IoakeimSogiakas/LibreHomeBus/hardware/Flavors/CH32V003FID4/FID4.xls

LCSC# | Mfr. | Mrf# | Description | Quantity | Product
C3191125 | TPS92520QDAPRQ1 | TI | LED Driver IC 2 Output DC-DC Buck PWM Analog Dimming 1600mA HTSSOP-32 | 1 | https://www.lcsc.com/product-detail/C3191125.html
C13832 | CL31B105KCHNNNE | Samsung Electro-Mechanics | 1uF ±10% 100V Ceramic Capacitor X7R 1206 | 5 | https://www.lcsc.com/product-detail/C13832.html
C577211 | CC1206KKX7R0BB225 | YAGEO | 2.2uF ±10% 100V Ceramic Capacitor X7R 1206 | 7 | https://www.lcsc.com/product-detail/C577211.html
C113906 | CC1206KRX7R9BB222 | YAGEO | 2.2nF ±10% 50V Ceramic Capacitor X7R 1206 | 3 | https://www.lcsc.com/product-detail/C113906.html
C1945 | CL31B104KCFNNNE | Samsung Electro-Mechanics | 100nF ±10% 100V Ceramic Capacitor X7R 1206 | 6 | https://www.lcsc.com/product-detail/C1945.html
C71084 | CL31B474KBHNNNE | Samsung Electro-Mechanics | 470nF ±10% 50V Ceramic Capacitor X7R 1206 | 2 | https://www.lcsc.com/product-detail/C71084.html
C14996 | SS210 | MDD(Microdiode Semiconductor) | Diode 100V 2A Surface Mount SMA(DO-214AC) | 2 | https://www.lcsc.com/product-detail/C14996.html
C18222152 | MNR1050T271MT | MetalLions | 900mA 270uH ±20% 1.5A 858mΩ Magnetic Shielded Inductor SMD,10x10mm Fixed Inductors | 2 | https://www.lcsc.com/product-detail/C18222152.html
C97853 | BLM18PG471SN1D | muRata | 470Ω@100MHz 1 Line Ferrite Bead 0603 1A 200mΩ | 2 | https://www.lcsc.com/product-detail/C97853.html
C54921095 | HRC0805F10R0FNTN | HWA CHN | 125mW 10Ω 150V Thick Film Resistor ±150ppm/℃ ±1% 0805 Chip Resistor - Surface Mount | 3 | https://www.lcsc.com/product-detail/C54921095.html
C55098665 | HRC0805J472 FNTN | HWA CHN | 125mW 4.7kΩ 150V Thick Film Resistor ±100ppm/℃ ±5% 0805 Chip Resistor - Surface Mount | 1 | https://www.lcsc.com/product-detail/C55098665.html
C54921094 | HRC0805F1002FNTN | HWA CHN | 10kΩ 125mW 150V Thick Film Resistor ±1% ±100ppm/℃ 0805 Chip Resistor - Surface Mount | 6 | https://www.lcsc.com/product-detail/C54921094.html
C48579717 | 1206X7R475K250NT | AIDE CAPACITOR | 4.7uF ±10% 25V Ceramic Capacitor X7R 1206 | 1 | https://www.lcsc.com/product-detail/C48579717.html
C6119987 | CGA1206X7R106K250NT | HRE | 10uF ±10% 25V Ceramic Capacitor X7R 1206 | 1 | https://www.lcsc.com/product-detail/C6119987.html
C5751958 | LM5168PDDAR | TI | Step-down type 1MHz Adjustable 300mA SO-PowerPAD-8 Voltage Regulators - DC DC Switching Regulators RoHS | 1 | https://www.lcsc.com/product-detail/C5751958.html
C18222021 | MNR4020T680MT | MetalLions | 500mA 68uH ±20% 670mA 1.13Ω Magnetic Shielded Inductor SMD,4x4mm Fixed Inductors | 1 | https://www.lcsc.com/product-detail/C18222021.html
C282859 | TCC1206X7R332K500DT | CCTC | 3.3nF ±10% 50V Ceramic Capacitor X7R 1206 | 1 | https://www.lcsc.com/product-detail/C282859.html
C915858 | TCC1206COG560J500DT | CCTC | 56pF ±5% 50V Ceramic Capacitor C0G 1206 | 1 | https://www.lcsc.com/product-detail/C915858.html
C55585661 | RI0805L2492FT | Guangdong Hottech | 24.9kΩ 125mW 150V Thick Film Resistor ±100ppm/℃ ±1% 0805 Chip Resistor - Surface Mount | 1 | https://www.lcsc.com/product-detail/C55585661.html
C50397082 | CL0805FN137KPS | CHANGLONG | 125mW 137kΩ 150V Thick Film Resistor ±1% 0805 Chip Resistor - Surface Mount RoHS | 1 | https://www.lcsc.com/product-detail/C50397082.html
C55098543 | HRC0805F1433FNTN | HWA CHN | 143kΩ 125mW 150V Thick Film Resistor ±1% ±100ppm/℃ 0805 Chip Resistor - Surface Mount | 1 | https://www.lcsc.com/product-detail/C55098543.html
C2918511 | CS3225X7R226K250NRL | SAMWHA | 22uF ±10% 25V Ceramic Capacitor X7R 1210 | 2 | https://www.lcsc.com/product-detail/C2918511.html
C55585667 | RI0805L4533FT | Guangdong Hottech | 453kΩ 125mW 150V Thick Film Resistor ±100ppm/℃ ±1% 0805 Chip Resistor - Surface Mount | 1 | https://www.lcsc.com/product-detail/C55585667.html
C140254 | SN75HVD3082EDR | TI | 4.5V~5.5V Transceiver 200Kbps 256 SOIC-8 Drivers, Receivers, Transceivers RoHS | 1 | https://www.lcsc.com/product-detail/C140254.html
C5199207 | CDSOT23-SM712-ES | ElecSuper | 19VC 26VC Clamp 17A Ipp ESD DIODE SOT-23 | 1 | https://www.lcsc.com/product-detail/C5199207.html
C54921099 | HRC0805F1200FNTN | HWA CHN | 125mW 120Ω 150V Thick Film Resistor ±1% ±100ppm/℃ 0805 Chip Resistor - Surface Mount | 1 | https://www.lcsc.com/product-detail/C54921099.html
C54921097 | HRC0805F1100FNTN | HWA CHN | 110Ω 125mW 150V Thick Film Resistor ±1% ±100ppm/℃ 0805 Chip Resistor - Surface Mount | 1 | https://www.lcsc.com/product-detail/C54921097.html
C47119819 | RTF06KR470FTG | FH | 470mΩ ±1% 250mW 1206 Metal Film Resistor | 2 | https://www.lcsc.com/product-detail/C47119819.html
C5187096 | CH32V003F4P6 | WCH | RISC-V2A 32 Bit 48MHz TSSOP-20-175mil Microcontrollers | 1 | https://www.lcsc.com/product-detail/C5187096.html
