IoakeimSogiakas/LibreHomeBus/hardware/Flavors/CH32V003FID4/CH32V003FID4.kicad_pcb

## KiCad design hardware/Flavors/CH32V003FID4/CH32V003FID4.kicad_pcb (2026-11-07)

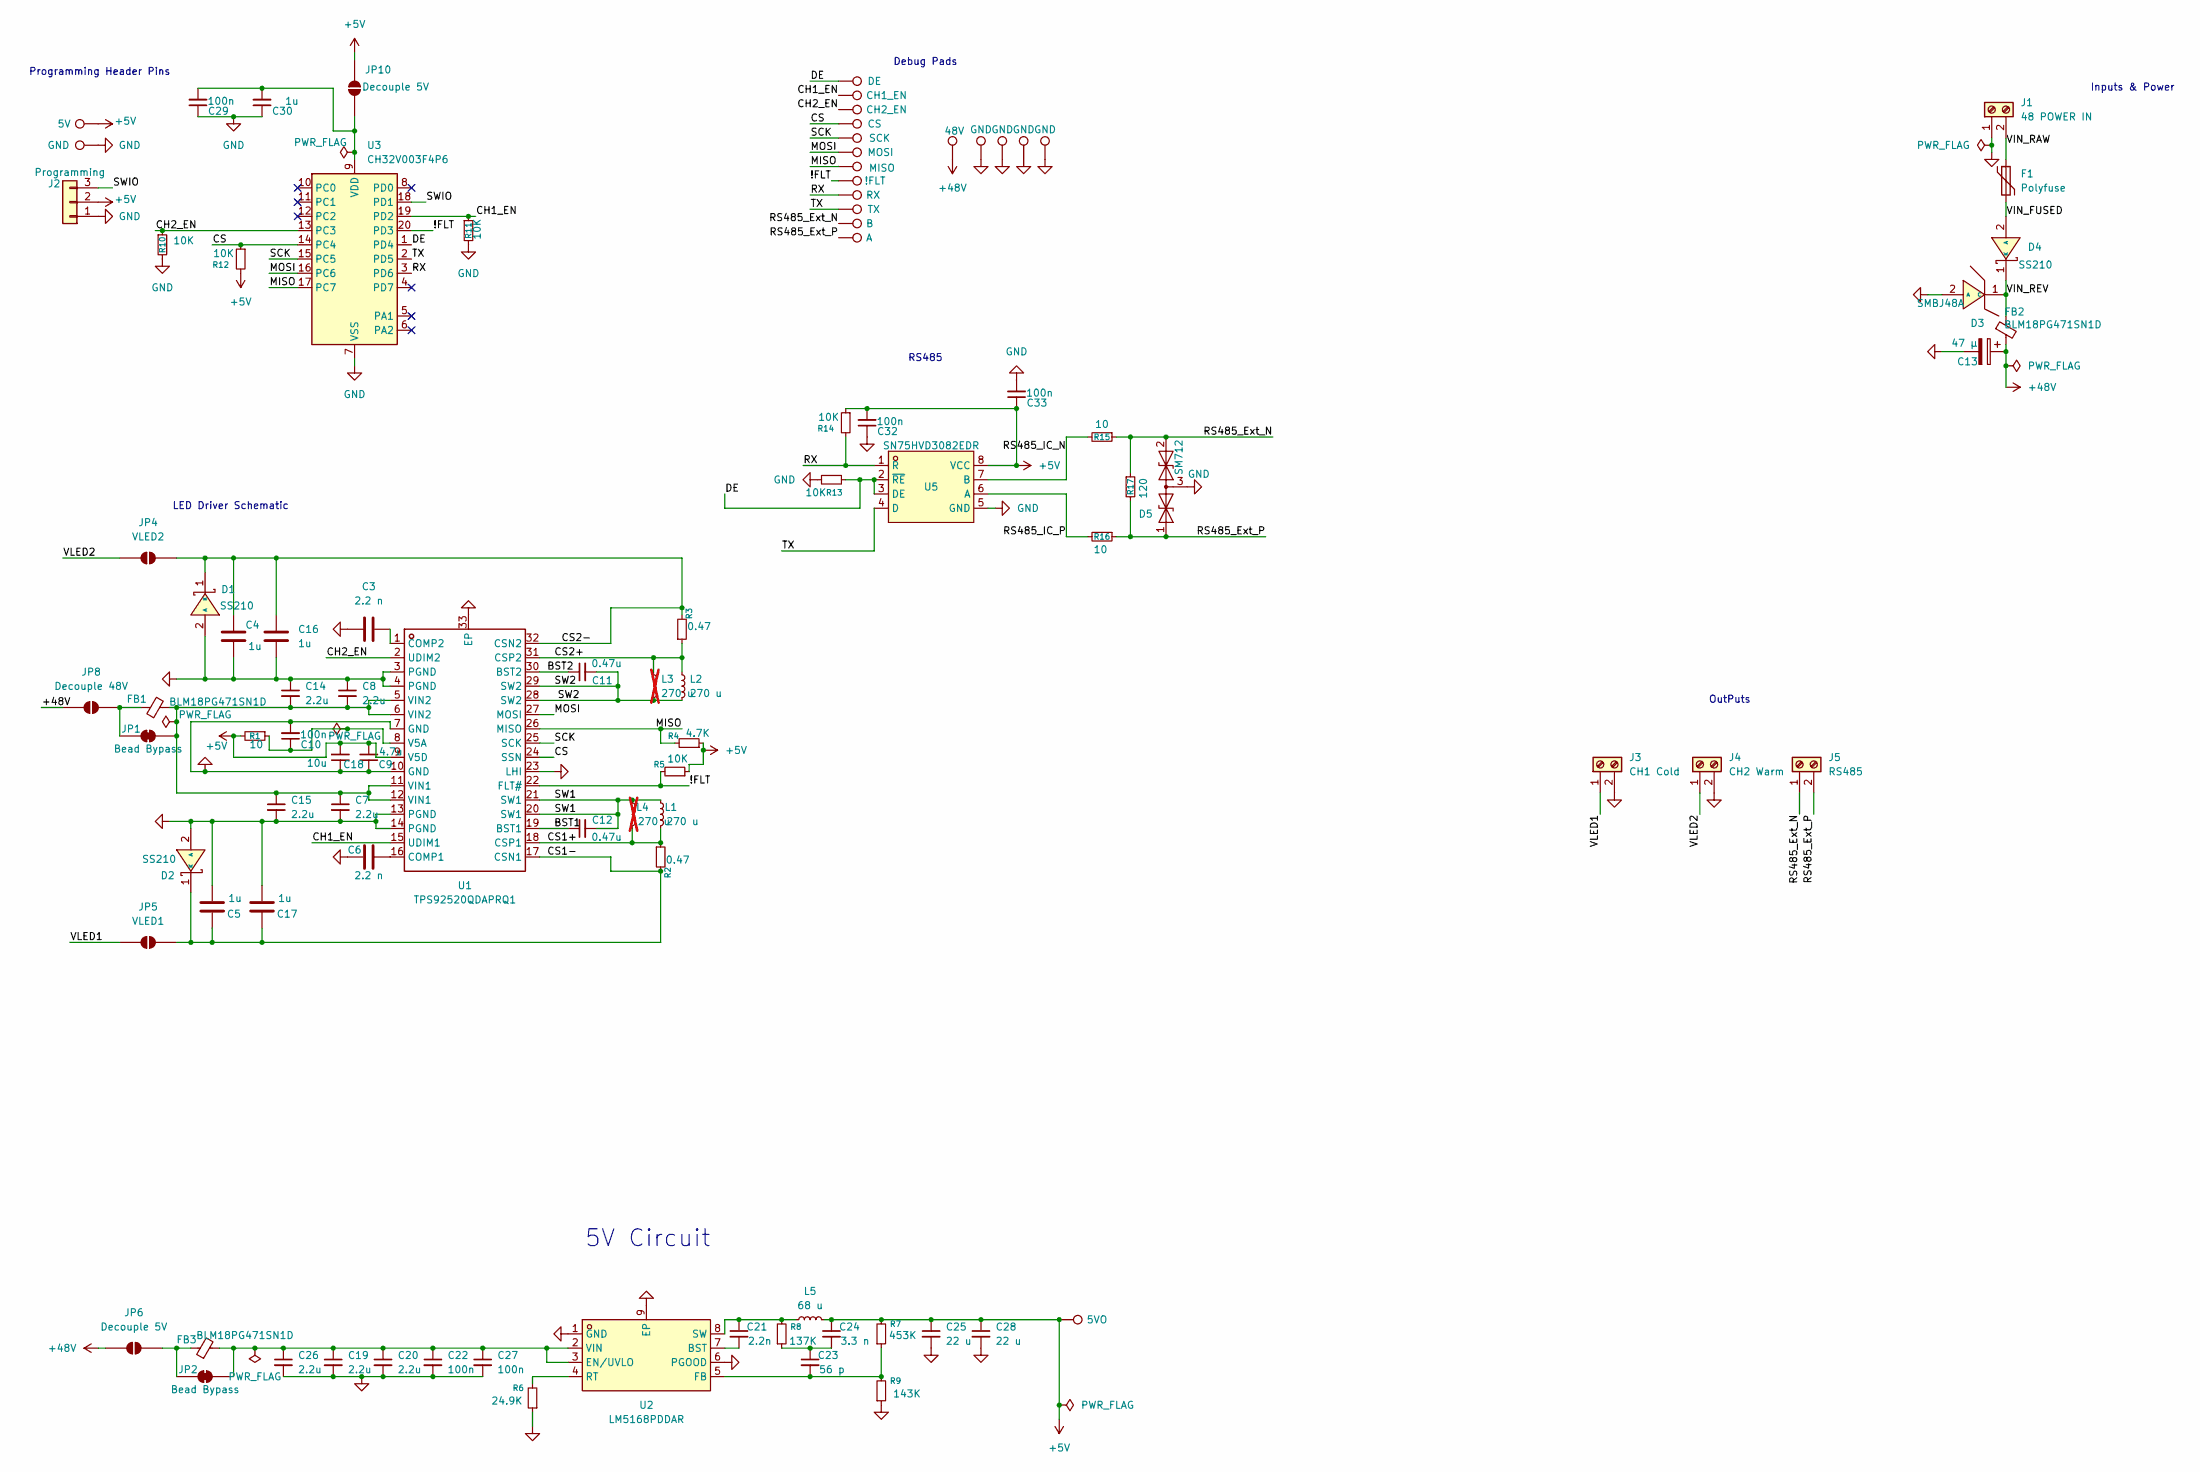
[picture p1: schematic CH32V003FID4.kicad_sch, Modbus Slave FID4 (CH32V003)]

Parts:
C3, C6: 2.2 n; C_1206_3216Metric
C4, C5, C16, C17, C30: 1u; C_1206_3216Metric
C7, C8, C14, C15, C19, C20, C26: 2.2u; C_1206_3216Metric
C9: 4.7u; C_1206_3216Metric
C10, C22, C27, C29, C32, C33: 100n; C_1206_3216Metric
C11, C12: 0.47u; C_1206_3216Metric
C13: 47 µ; CP_Elec_10x10.5
C18: 10u; C_1206_3216Metric
C21: 2.2n; C_1206_3216Metric
C23: 56 p; C_1206_3216Metric
C24: 3.3 n; C_1206_3216Metric
C25, C28: 22 u; C_1206_3216Metric
D1, D2, D4: SS210; D_SMA; MPN SS210; LCSC Part C14996
D3: SMBJ48A; SMB_L4.6-W3.6-LS5.3-RD; MPN SMBJ48A; LCSC Part C353356
D5: SM712; SOT-23; LCSC C5199207
F1: Polyfuse; Fuse_1812_4532Metric
FB1, FB2, FB3: BLM18PG471SN1D; L_0603_1608Metric
J1: 48 POWER IN; TerminalBlock_Phoenix_MKDS-1,5-2_1x02_P5.00mm_Horizontal
J2: Programming; PinHeader_1x03_P2.54mm_Vertical
J3: CH1 Cold; TerminalBlock_Phoenix_MKDS-1,5-2_1x02_P5.00mm_Horizontal
J4: CH2 Warm; TerminalBlock_Phoenix_MKDS-1,5-2_1x02_P5.00mm_Horizontal
J5: RS485; TerminalBlock_Phoenix_MKDS-1,5-2_1x02_P5.00mm_Horizontal
JP1, JP2: Bead Bypass; SolderJumper-2_P1.3mm_Bridged_RoundedPad1.0x1.5mm
JP4: VLED2; SolderJumper-2_P1.3mm_Open_RoundedPad1.0x1.5mm
JP5: VLED1; SolderJumper-2_P1.3mm_Open_RoundedPad1.0x1.5mm
JP6, JP10: Decouple 5V; SolderJumper-2_P1.3mm_Open_RoundedPad1.0x1.5mm
JP8: Decouple 48V; SolderJumper-2_P1.3mm_Open_RoundedPad1.0x1.5mm
L1, L2: 270 u; L_10.4x10.4_H4.8
L3, L4: 270 u; L_Bourns_SRR1260; not fitted
L5: 68 u; L_APV_ANR4020
R1, R15, R16: 10; R_0805_2012Metric
R2, R3: 0.47; R_0805_2012Metric
R4: 4.7K; R_0805_2012Metric
R5, R10, R11, R12, R13, R14: 10K; R_0805_2012Metric
R6: 24.9K; R_0805_2012Metric
R7: 453K; R_0805_2012Metric
R8: 137K; R_0805_2012Metric
R9: 143K; R_0805_2012Metric
R17: 120; R_0805_2012Metric
TP2: 5V; TestPoint_Pad_D1.5mm
TP3, TP12, TP13, TP14, TP15: GND; TestPoint_Pad_D1.5mm
TP4: CH2_EN; TestPoint_Pad_D1.5mm
TP5: CS; TestPoint_Pad_D1.5mm
TP6: SCK; TestPoint_Pad_D1.5mm
TP7: MOSI; TestPoint_Pad_D1.5mm
TP8: MISO; TestPoint_Pad_D1.5mm
TP9: CH1_EN; TestPoint_Pad_D1.5mm
TP10: !FLT; TestPoint_Pad_D1.5mm
TP11: 48V; TestPoint_Pad_D1.5mm
TP19: 5VO; TestPoint_Pad_D1.5mm
TP20: DE; TestPoint_Pad_D1.5mm
TP21: RX; TestPoint_Pad_D1.5mm
TP22: TX; TestPoint_Pad_D1.5mm
TP23: B; TestPoint_Pad_D1.5mm
TP24: A; TestPoint_Pad_D1.5mm
U1: TPS92520QDAPRQ1; MPN TPS92520QDAPRQ1; LCSC C3191125
U2: LM5168PDDAR; MPN LM5168PDDAR; LCSC Part C5751958
U3: CH32V003F4P6; TSSOP-20_4.4x6.5mm_P0.65mm; MPN CH32V003F4P6; LCSC C5187096
U5: SN75HVD3082EDR; MPN SN75HVD3082EDR; LCSC Part C140254

Connections:
+5V: C9.2, C18.2, C24.1, C25.1, C28.1, C32.2, C33.1, J2.2, JP10.2 (B), L5.2, R1.2, R4.1, R5.1, R7.2, R12.2, R14.1, TP2.1 (1_1), TP19.1 (1_1), U1.9 (V5D), U5.8 (VCC)
+48V: C13.1, FB2.2, JP6.1 (A), JP8.1 (A), TP11.1 (1_1)
/!FLT: R5.2, TP10.1 (1_1), U1.22 (FLT#), U3.20 (PD3)
/BST1: C12.1, U1.19 (BST1)
/BST2: C11.1, U1.30 (BST2)
/CH1_EN: R11.1, TP9.1 (1_1), U1.15 (UDIM1), U3.19 (PD2)
/CH2_EN: R10.1, TP4.1 (1_1), U1.2 (UDIM2), U3.13 (PC3)
/CS: R12.1, TP5.1, U1.24 (SSN), U3.14 (PC4)
/CS1+: L1.1, L4.1, R2.1, U1.18 (CSP1)
/CS1-: C5.1, C17.1, D2.1 (K), JP5.2 (B), R2.2, U1.17 (CSN1)
/CS2+: L2.1, L3.1, R3.1, U1.31 (CSP2)
/CS2-: C4.1, C16.1, D1.1 (K), JP4.2 (B), R3.2, U1.32 (CSN2)
/DE: R13.2, TP20.1 (1_1), U3.1 (PD4), U5.2 (~RE), U5.3 (DE)
/MISO: R4.2, TP8.1, U1.26 (MISO), U3.17 (PC7)
/MOSI: TP7.1, U1.27 (MOSI), U3.16 (PC6)
/RS485_Ext_N: D5.2 (A2), J5.1, R15.1, R17.1, TP23.1 (1_1)
/RS485_Ext_P: D5.1 (A1), J5.2, R16.1, R17.2, TP24.1 (1_1)
/RS485_IC_N: R15.2, U5.7 (B)
/RS485_IC_P: R16.2, U5.6 (A)
/RX: R14.2, TP21.1 (1_1), U3.3 (PD6), U5.1 (R)
/SCK: TP6.1, U1.25 (SCK), U3.15 (PC5)
/SW1: C12.2, L1.2, L4.2, U1.20 (SW1), U1.21 (SW1)
/SW2: C11.2, L2.2, L3.2, U1.28 (SW2), U1.29 (SW2)
/SWIO: J2.3, U3.18 (PD1)
/TX: TP22.1 (1_1), U3.2 (PD5), U5.4 (D)
/VIN_FUSED: D4.2 (A), F1.2
/VIN_RAW: F1.1, J1.2
/VIN_REV: D3.1 (C), D4.1 (K), FB2.1
/VLED1: J3.1, JP5.1 (A)
/VLED2: J4.1, JP4.1 (A)
GND: C3.1, C4.2, C5.2, C6.1, C7.2, C8.1, C9.1, C10.2, C13.2, C14.1, C15.2, C16.2, C17.2, C18.1, C19.2, C20.2, C22.2, C25.2, C26.2, C27.2, C28.2, C29.1, C30.1, C32.1, C33.2, D1.2 (A), D2.2 (A), D3.2 (A), D5.3 (common), J1.1, J2.1, J3.2, J4.2, R6.1, R9.1, R10.2, R11.2, R13.1, TP3.1 (1_1), TP12.1 (1_1), TP13.1 (1_1), TP14.1 (1_1), TP15.1 (1_1), U1.3 (PGND), U1.4 (PGND), U1.7 (GND), U1.10 (GND), U1.13 (PGND), U1.14 (PGND), U1.23 (LHI), U1.33 (EP), U2.1 (GND), U2.6 (PGOOD), U2.9 (EP), U3.7 (VSS), U5.5 (GND)
unnamed: C23.1, C24.2, R8.1
unnamed: FB1.1, JP1.1 (A), JP8.2 (B)
unnamed: C7.1, C8.2, C14.2, C15.1, FB1.2, JP1.2 (B), U1.5 (VIN2), U1.6 (VIN2), U1.11 (VIN1), U1.12 (VIN1)
unnamed: FB3.1, JP2.1 (A), JP6.2 (B)
unnamed: C19.1, C20.1, C22.1, C26.1, C27.1, FB3.2, JP2.2 (B), U2.2 (VIN), U2.3 (EN/UVLO)
unnamed: C29.2, C30.2, JP10.1 (A), U3.9 (VDD)
unnamed: C6.2, U1.16 (COMP1)
unnamed: C3.2, U1.1 (COMP2)
unnamed: C10.1, R1.1, U1.8 (V5A)
unnamed: C21.2, U2.7 (BST)
unnamed: C23.2, R7.1, R9.2, U2.5 (FB)
unnamed: R6.2, U2.4 (RT)
unnamed: C21.1, L5.1, R8.2, U2.8 (SW)

Notes on the sheet:
RS485
5V Circuit
Inputs & Power
Programming Header Pins
Debug Pads
LED Driver Schematic
OutPuts

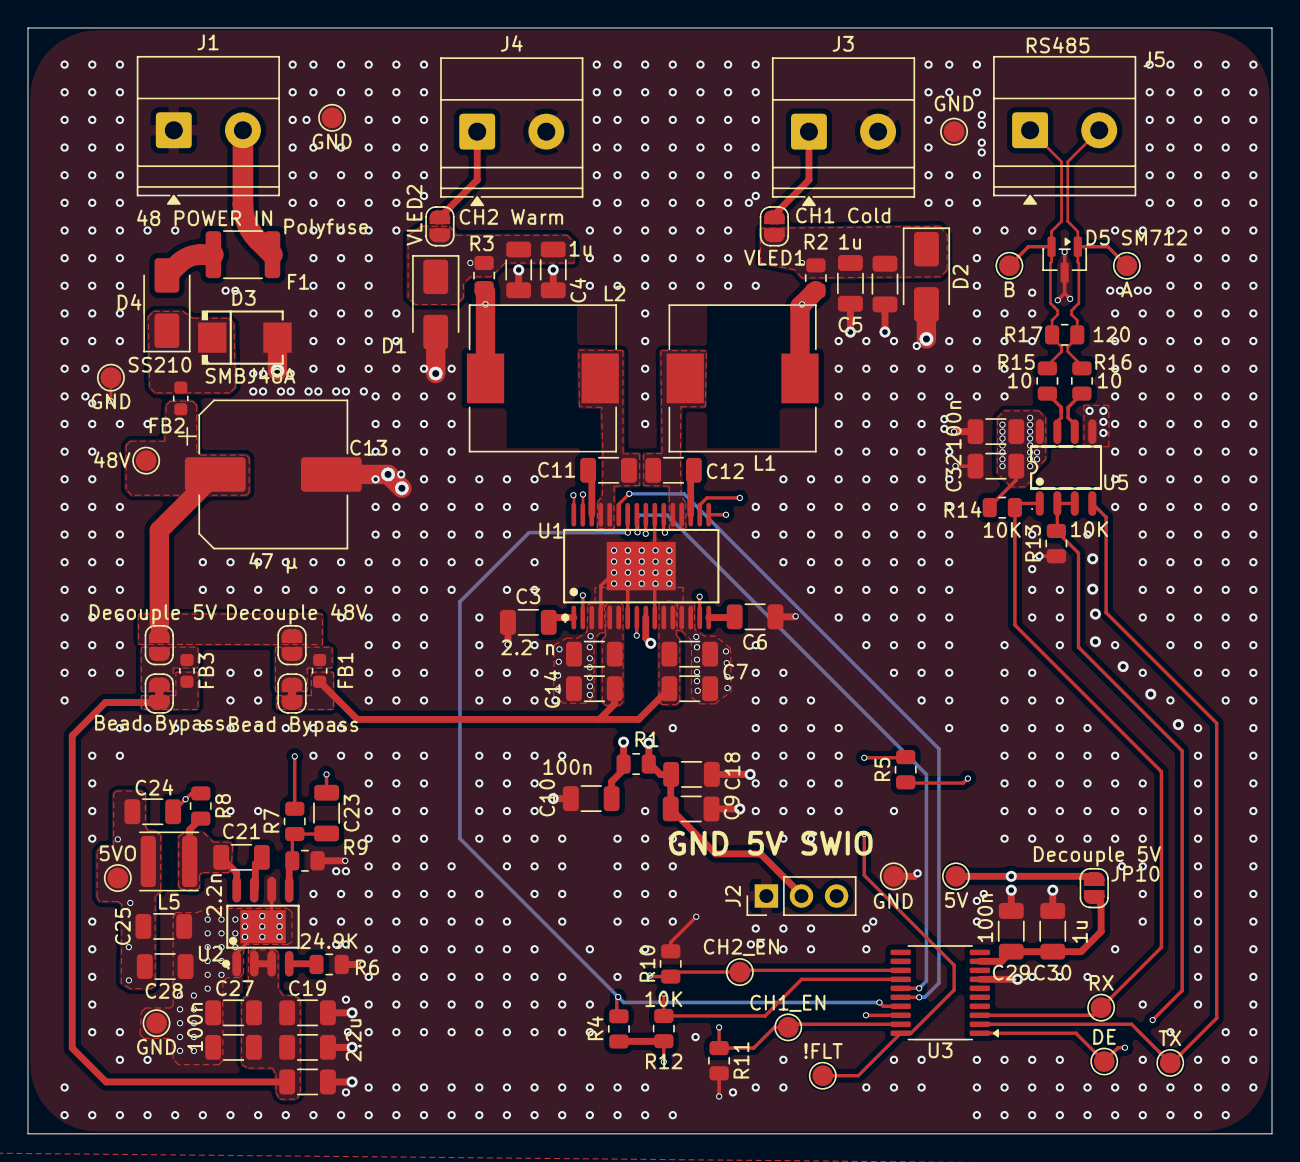
[picture p2: board CH32V003FID4.kicad_pcb from above]

Board: 4 copper layers, 90.0 x 80.0 mm, 91 parts (0 on the bottom side), 44 nets.
