IoakeimSogiakas/LibreHomeBus/(commit log)

2026-10-18 added FID6 (wall plug with manual switch) added a descovery light on FID1/6
2026-10-19 Split main.c into smaller files
    main.c was getting long, so I broke it up:
    - modbus.c: UART, framing, CRC, read/write
    - discovery.c: UID, saved address, broadcast stuff
    - flavors.c: the switch/LED code and all the flavors
    - node.h: what the files share
    - config.h: flavor list and the default FLAVOR/DEFAULT_ID
    Benchtested FID6, and cleaned up a few comments.
2026-10-19 Update README.md: Add identification LED details for switch and plug nodes
2026-10-22 FIST ACTUALL PHYSICAL TESTS ON RS485!!! - Twicked timming on discovery script and changed what counts as a no - Removed some debug lines in slave from the frame_poll() section this was breaking CRC c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
2026-10-25 refactor(project): reorganize structure for to include KiCAD files - Moved the firwmare side in the /firmware folder - Update platformio.ini paths to match the new path - Added KiCad project files an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
2026-10-25 Updated .gitignore do ignore Syncthing folders and files (I am using the later to cloud sync KiCAD without making a mess of commits in GitHub) also added a Minichlink Debug Terminal in the taskbar an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
2026-10-27 Syncing the latest update on KiCAD (these updates are going to be randomly pushed i am not using Git for tracking it) and probably stuff will be without meaningfull commits. Commits are mainly for th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
2026-10-29 Add discovery cache, S3-Zero target and shared flavor table
    - Discovery.py saves UID and FID per address to cache.json
    - New s3zero target for the Waveshare ESP32-S3-Zero
    - Move ESPHome headers to headers.py
    - Add flavors.py with register layout per FID, used by both scripts
    - bus_test.py: forget a node by address, UID comes from the cache
    - bus_test.py: show register names when reading a node
    - Add requirements.txt
2026-11-02 Schematic for FID4 complete
2026-11-07 Prototype board done: used big items 1206 and 0805 to make assembly and testing easier
